NTNU-TDT4295/slamdunk/tools/simulator/assets/models/head.obj

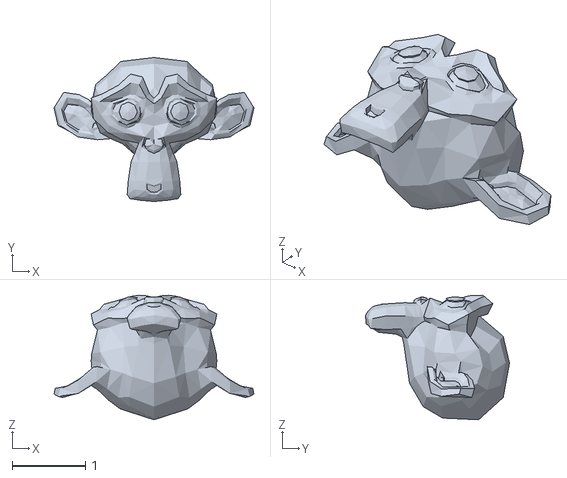
[picture p4: CAD file, 2018-09-21]
tools/simulator/assets/models/head.obj
2.73 x 1.97 x 1.70
