NTNU-TDT4295/slamdunk/tools/simulator/assets/models/sphere.obj

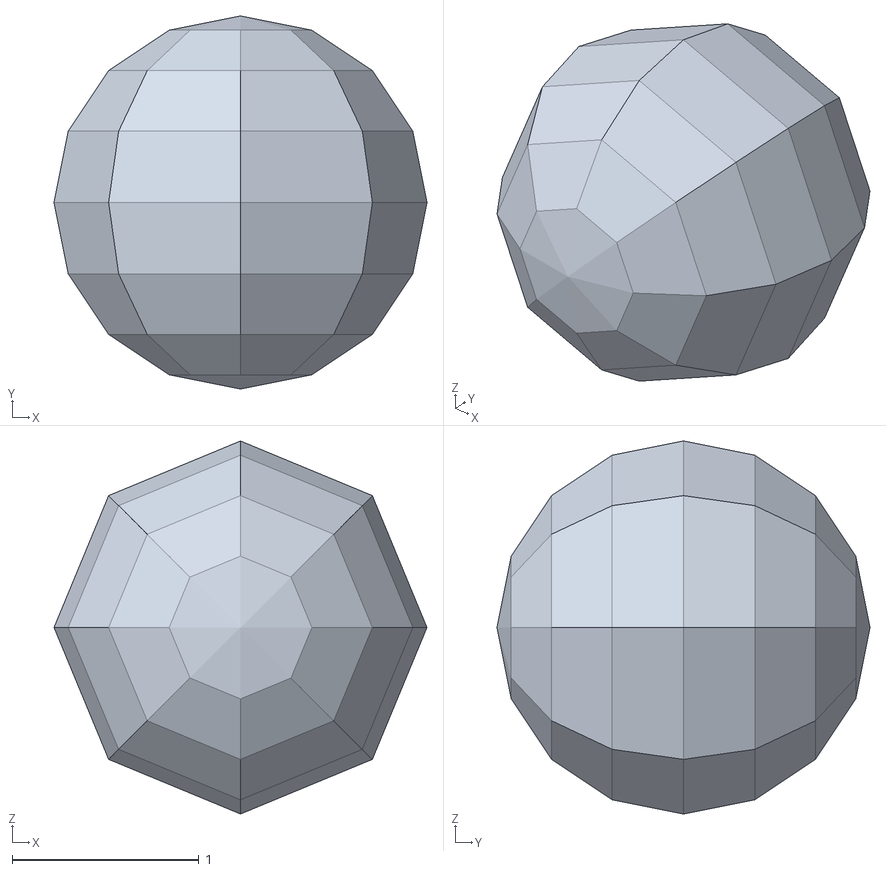
[picture p5: CAD file, 2018-09-20]
tools/simulator/assets/models/sphere.obj
2.00 x 2.00 x 2.00
