NTNU-TDT4295/slamdunk/tools/simulator/assets/models/room.obj

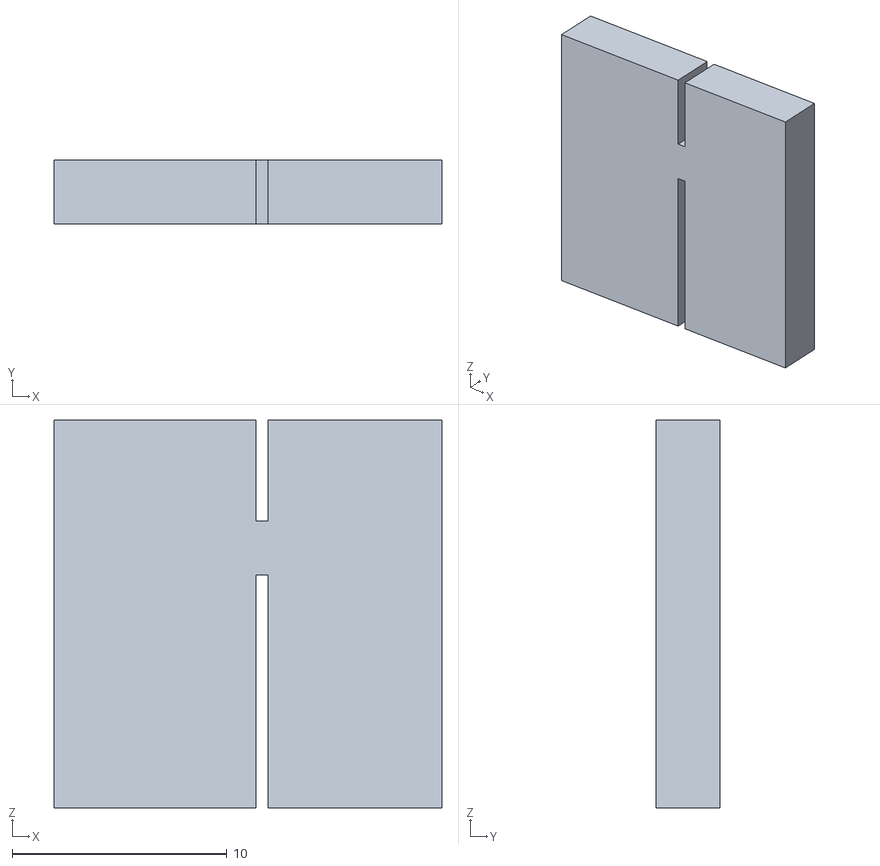
[picture p6: CAD file, 2018-09-18]
tools/simulator/assets/models/room.obj
18.1 x 3.00 x 18.0
