NTNU-TDT4295/slamdunk/tools/simulator/assets/models/cube.obj

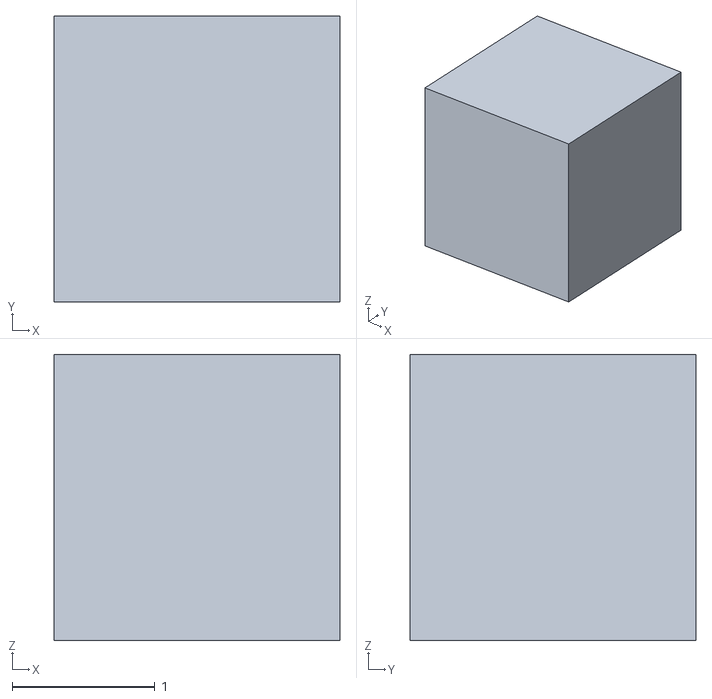
[picture p7: CAD file, 2018-09-18]
tools/simulator/assets/models/cube.obj
2.00 x 2.00 x 2.00
