NTNU-TDT4295/slamdunk/pcb/pcb.kicad_pcb

## KiCad design pcb/pcb.kicad_pcb (2018-10-03)

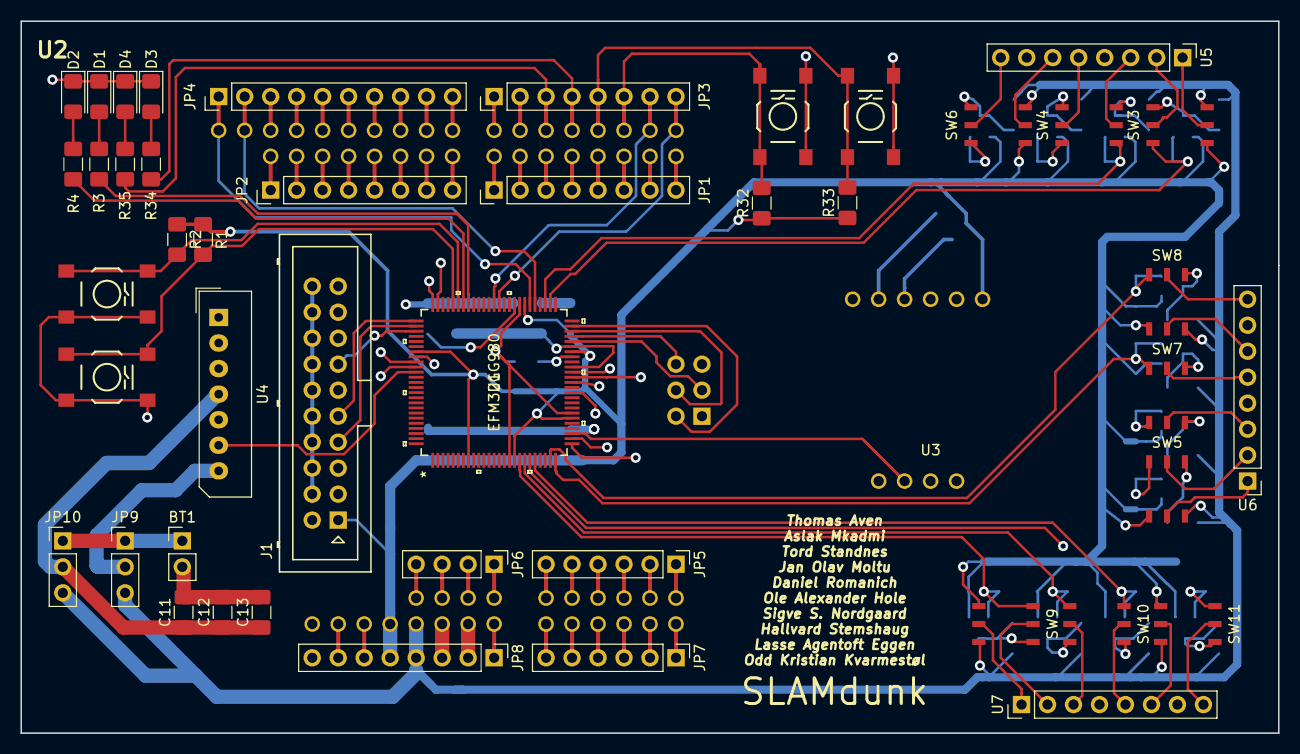
[picture p13: board pcb.kicad_pcb from above]

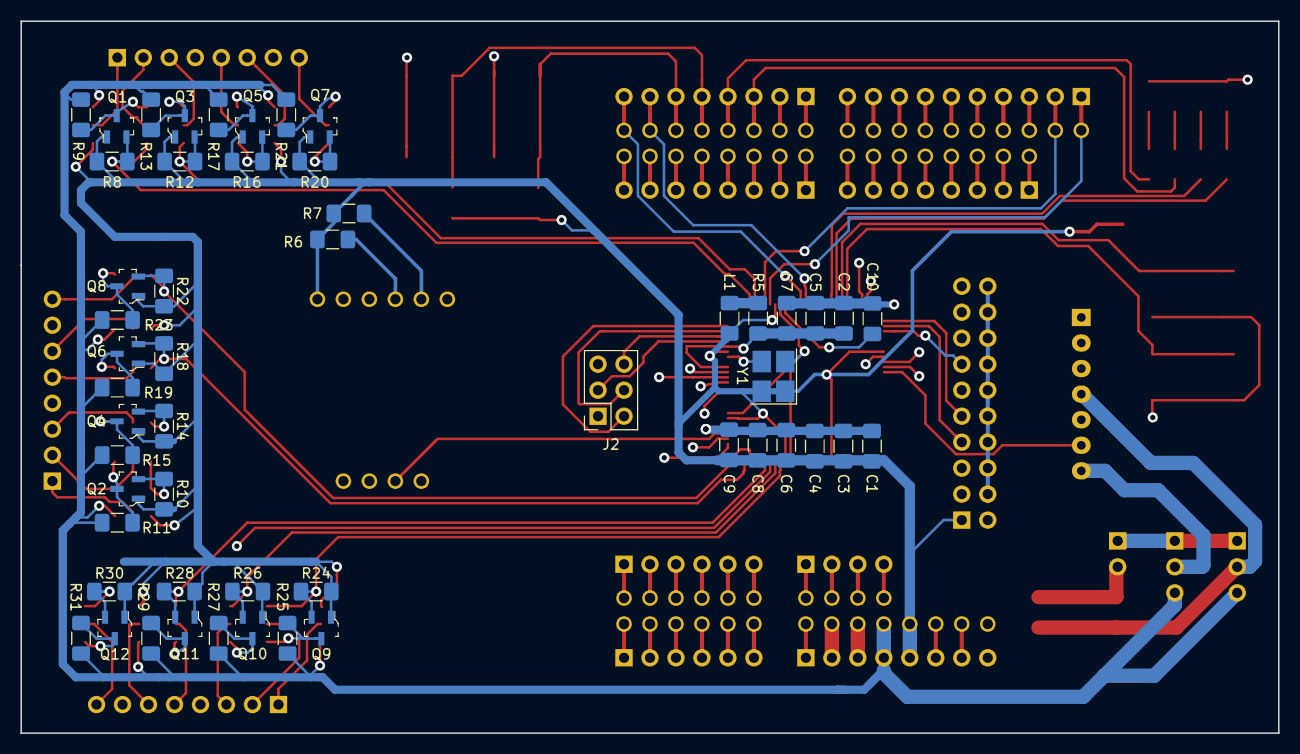
[picture p14: board pcb.kicad_pcb from below]

Board: 4 copper layers, 122.9 x 69.6 mm, 99 parts (52 on the bottom side), 128 nets.

Parts:
BT1: Battery; PinHeader_1x02_P2.54mm_Vertical
C1, C3, C4, C6, C8: 100n; C_1206_3216Metric_Pad1.42x1.75mm_HandSolder
C2, C5: 10nF; C_1206_3216Metric_Pad1.42x1.75mm_HandSolder
C7, C10: 1uF; C_1206_3216Metric_Pad1.42x1.75mm_HandSolder
C9: 10u; C_1206_3216Metric_Pad1.42x1.75mm_HandSolder
C11: 10μF; C_1206_3216Metric_Pad1.42x1.75mm_HandSolder
C12: 1μF; C_1206_3216Metric_Pad1.42x1.75mm_HandSolder
C13: 100nF; C_1206_3216Metric_Pad1.42x1.75mm_HandSolder
D1, D2, D3, D4: LED; LED_1206_3216Metric_Pad1.42x1.75mm_HandSolder
J1: Conn_02x10_Odd_Even; Multicomp_MC9A12-2034_2x10_P2.54mm_Vertical
J2: Conn_02x03_Counter_Clockwise; PinSocket_2x03_P2.54mm_Vertical
JP1, JP2, JP3, JP8: M08; PinHeader_1x08_P2.54mm_Vertical
JP4: M10; PinHeader_1x10_P2.54mm_Vertical
JP5, JP7: M06; PinHeader_1x06_P2.54mm_Vertical
JP6: M04; PinHeader_1x04_P2.54mm_Vertical
JP9, JP10: Jumper_NC_Dual; PinHeader_1x03_P2.54mm_Vertical
L1: 742792662; L_1206_3216Metric_Pad1.42x1.75mm_HandSolder
Q1, Q2, Q3, Q4, Q5, Q6, Q7, Q8, Q9, Q10, Q11, Q12: BSS138; SOT-23-3
R1, R2, R3, R4, R32, R33, R34, R35: R; R_1206_3216Metric_Pad1.42x1.75mm_HandSolder
R5: 1; R_1206_3216Metric_Pad1.42x1.75mm_HandSolder
R6: 2.2k; R_1206_3216Metric_Pad1.42x1.75mm_HandSolder
R7: 4.7k; R_1206_3216Metric_Pad1.42x1.75mm_HandSolder
R8, R9, R10, R11, R12, R13, R14, R15, R16, R17, R18, R19, R20, R21, R22, R23, R24, R25, R26, R27, R28, R29, R30, R31: 10k; R_1206_3216Metric_Pad1.42x1.75mm_HandSolder
SW1, SW2, SW12, SW13: SW_PUSHBUTTON; SW_PUSHBUTTON_SMD
SW3, SW4, SW5, SW6, SW7, SW8, SW9, SW10, SW11: SW_2xSPDT; CAS-D20TB
U1: EFM32GG980
U2: ARDUINO_PYNQ_SHIELD
U3: IMU; BNO055
U4: lidar; Molex_SPOX_5267-07A_1x07_P2.50mm_Vertical
U5, U6, U7: ULTRASONIC-GPIO; PinHeader_1x08_P2.54mm_Vertical
Y1: Crystal_GND23; Crystal_SMD_3225-4Pin_3.2x2.5mm_HandSoldering

Connections:
+3V3: C1.1, C3.1, C4.1, C6.1, C8.1, C9.1, J1.1, JP8.5, L1.1, Q1.1, Q2.1, Q3.1, Q4.1, Q5.1, Q6.1, Q7.1, Q8.1, Q9.1, Q10.1, Q11.1, Q12.1, R1.1, R2.1, R6.1, R7.1, R8.1, R10.1, R12.1, R14.1, R16.1, R18.1, R20.1, R22.1, R24.1, R26.1, R28.1, R30.1, R32.1, R33.1, SW3.3, SW5.3, SW6.3, SW8.3, SW9.3, SW11.3, U1.8, U1.17, U1.31, U1.44, U1.57, U1.82, U2.3V3, U3.6, Y1.1, Y1.4
/AVDD_DEC: C2.1, C5.1, C7.1, R5.2, U1.41, U1.45
/CLOCK/HFXTAL_N: U1.43, Y1.3
/DEC: C10.2, U1.59
/EFM_DEBUG/LED_1: R3.1, U1.68
/EFM_DEBUG/LED_2: R4.1, U1.69
/EFM_DEBUG/SW_1: R1.2, SW1.1, U1.71
/EFM_DEBUG/SW_2: R2.2, SW2.1, U1.70
/JTAG/SWCLK: J1.9, U1.76
/JTAG/SWDIO: J1.7, U1.77
/JTAG/SWO: J1.13, U1.78
/LIDAR/MOTO_CTRL: U1.86, U4.6
/LIDAR/RX: U1.85, U4.3
/LIDAR/TX: U1.84, U4.2
/MCU_RST: J1.15, U1.36
/PA7_C1: Q2.2, R10.2, SW5.6, U1.26
/PA8_C2: Q4.2, R14.2, SW7.3, U1.27
/PA9_IMU_INT: U1.28, U3.9
/PB7_CTX: Q8.2, R22.2, SW8.6, U1.24
/PB8_CRX: Q6.2, R18.2, SW7.6, U1.25
/PB10_IMU_RST: U1.38, U3.1
/PB11_IMU_SDA: R6.2, U1.39, U3.3
/PB12_IMU_SCL: R7.2, U1.40, U3.2
/PC0_B1: Q9.2, R24.2, SW9.6, U1.18
/PC1_B2: Q10.2, R26.2, SW10.3, U1.19
/PC2_BTX: Q12.2, R30.2, SW11.6, U1.20
/PC3_BRX: Q11.2, R28.2, SW10.6, U1.21
/PD6_A1: Q1.2, R8.2, SW3.6, U1.52
/PD7_A2: Q3.2, R12.2, SW4.3, U1.53
/PF10_ATX: Q7.2, R20.2, SW6.6, U1.74
/PF11_ARX: Q5.2, R16.2, SW4.6, U1.75
/PYNQ-DEBUG/LED_1: JP3.4, R34.1, U2.4
/PYNQ-DEBUG/LED_2: JP3.3, R35.1, U2.5
/PYNQ-DEBUG/SW_1: JP3.6, R32.2, SW12.1, U2.2
/PYNQ-DEBUG/SW_2: JP3.5, R33.2, SW13.1, U2.3
/PYNQ_RX: JP3.8, U1.62, U2.0
/PYNQ_SCL: JP4.1, U1.56, U2.SCL
/PYNQ_SDA: JP4.2, U1.55, U2.SDA
/PYNQ_TX: JP3.7, U1.63, U2.1
/SPI/MISO: J2.6, U1.47
/SPI/MOSI: J2.3, U1.46
/SPI/SCLK: J2.4, U1.48
/SPI/SS: J2.2, U1.49
GND: BT1.2, C1.2, C2.2, C3.2, C4.2, C5.2, C6.2, C7.2, C8.2, C9.2, C10.1, C11.2, C12.2, C13.2, D1.1, D2.1, D3.1, D4.1, J1.4, J1.6, J1.8, J1.10, J1.12, J1.14, J1.16, J1.18, J1.20, JP8.2, JP8.3, SW1.2, SW2.2, SW12.2, SW13.2, U1.16, U1.32, U1.58, U1.83, U2.GND1, U2.GND2, U3.4, U4.1, U4.5, U5.4, U5.7, U6.4, U6.7, U7.4, U7.7, Y1.2
unnamed: BT1.1, JP9.1, JP10.1
unnamed: C11.1, C12.1, C13.1, JP10.2, U4.4
unnamed: D1.2, R3.2
unnamed: D2.2, R4.2
unnamed: D3.2, R34.2
unnamed: D4.2, R35.2
unnamed: JP1.1, U2.33
unnamed: JP1.2, U2.32
unnamed: JP1.3, U2.31
unnamed: JP1.4, U2.30
unnamed: JP1.5, U2.29
unnamed: JP1.6, U2.28
unnamed: JP1.7, U2.27
unnamed: JP1.8, U2.26
unnamed: JP2.1, U2.41
unnamed: JP2.2, U2.40
unnamed: JP2.3, U2.39
unnamed: JP2.4, U2.38
unnamed: JP2.5, U2.37
unnamed: JP2.6, U2.36
unnamed: JP2.7, U2.35
unnamed: JP2.8, U2.34
unnamed: JP3.1, U2.7
unnamed: JP3.2, U2.6
unnamed: JP4.3, U2.A_R
unnamed: JP4.4, U2.G
unnamed: JP4.5, U2.13
unnamed: JP4.6, U2.12
unnamed: JP4.7, U2.11
unnamed: JP4.8, U2.10
unnamed: JP4.9, U2.9
unnamed: JP4.10, U2.8
unnamed: JP5.1, U2.A11
unnamed: JP5.2, U2.A10
unnamed: JP5.3, U2.A9
unnamed: JP5.4, U2.A8
unnamed: JP5.5, U2.A7
unnamed: JP5.6, U2.A6
unnamed: JP6.1, U2.XV_R
unnamed: JP6.2, U2.XGND
unnamed: JP6.3, U2.V_N
unnamed: JP6.4, U2.V_P
unnamed: JP7.1, U2.A5
unnamed: JP7.2, U2.A4
unnamed: JP7.3, U2.A3
unnamed: JP7.4, U2.A2
unnamed: JP7.5, U2.A1
unnamed: JP7.6, U2.A0
unnamed: JP8.1, U2.VIN
unnamed: JP8.6, U2.RST
unnamed: JP8.7, U2.IO_R
unnamed: JP9.2, U4.7
unnamed: L1.2, R5.1
unnamed: Q1.3, R9.2, SW3.4
unnamed: Q2.3, R11.2, SW5.4
unnamed: Q3.3, R13.2, SW4.1
unnamed: Q4.3, R15.2, SW7.1
unnamed: Q5.3, R17.2, SW4.4
unnamed: Q6.3, R19.2, SW7.4
unnamed: Q7.3, R21.2, SW6.4
unnamed: Q8.3, R23.2, SW8.4
unnamed: Q9.3, R25.2, SW9.4
unnamed: Q10.3, R27.2, SW10.1
unnamed: Q11.3, R29.2, SW10.4
unnamed: Q12.3, R31.2, SW11.4
unnamed: SW3.2, U5.1
unnamed: SW3.5, U5.2
unnamed: SW4.2, U5.3
unnamed: SW4.5, U5.5
unnamed: SW5.2, U6.1
unnamed: SW5.5, U6.2
unnamed: SW6.2, U5.6
unnamed: SW6.5, U5.8
unnamed: SW7.2, U6.3
unnamed: SW7.5, U6.5
unnamed: SW8.2, U6.6
unnamed: SW8.5, U6.8
unnamed: SW9.2, U7.1
unnamed: SW9.5, U7.2
unnamed: SW10.2, U7.3
unnamed: SW10.5, U7.5
unnamed: SW11.2, U7.6
unnamed: SW11.5, U7.8
VCC: JP8.4, JP9.3, JP10.3, R9.1, R11.1, R13.1, R15.1, R17.1, R19.1, R21.1, R23.1, R25.1, R27.1, R29.1, R31.1, SW3.1, SW5.1, SW6.1, SW8.1, SW9.1, SW11.1, U2.5V
