NTNU-TDT4295/slamdunk/efm32/source/sonar.c

#include "sonar.h"
#include "setup.h"
#include <stdio.h>

void sonar_callback(uint8_t pin)
{
	/* // Time the amount of microseconds the pin is high */
	/* uint32_t microsecond = TIMER_FREQ / 1000000; */
	/* uint32_t elapsed = 0; */

	/* TIMER0->CNT = 0; */
	/* TIMER0->CMD = TIMER_CMD_START; */

	/* while (GPIO_PinInGet(gpioPortD, 2)) { */
	/* 	// Gernal purpose timers are 16-bit, we need to extend */
	/* 	// this to account for overflow later (TODO) */
	/* 	if (TIMER0->CNT > 65000) { */
	/* 		elapsed = 0; */
	/* 		break; */
	/* 	} else { */
	/* 		elapsed = TIMER0->CNT; */
	/* 	} */
	/* } */

	/* TIMER0->CMD = TIMER_CMD_STOP; */
}

void init_sonar()
{
	// Interrupt dispatcher
	GPIOINT_Init();

	// PD2 - echo, PD3 - trig
	GPIO_PinModeSet(gpioPortD, 2, gpioModeInput, 0);
	GPIO_PinModeSet(gpioPortD, 3, gpioModePushPull, 0);

	// Port, pin, rising edge, falling edge, enable
	GPIO_IntConfig(gpioPortD, 2, true, false, true);

	// IRQ handlers are defined in gpiointerrupt.c to dispatch
	// callbacks so that we don't scatter definitions
	GPIOINT_CallbackRegister(2, sonar_callback);
}

void trigger_sonar()
{
	GPIO_PinOutClear(gpioPortD, 3);
	DelayUs(2);
	GPIO_PinOutSet(gpioPortD, 3);
	DelayUs(10);
	GPIO_PinOutClear(gpioPortD, 3);

	// Check echo -- this is interrupt driven for now (TODO)
}
