NTNU-TDT4295/slamdunk/efm32/include/setup.h

#ifndef SETUP_H
#define SETUP_H

#include <stdint.h>
#include <stdbool.h>
#include "em_chip.h"
#include "em_cmu.h"

#define RTC_FREQ 32768
#define TIMER_FREQ 48000000

// counter for Delay ticks to sleep
volatile uint32_t msTicks;
void Delay(uint32_t dlyTicks);
void DelayMs(int ms);
void DelayUs(int us);
void SysTick_Handler(void);

void init(void);

#endif
