NTNU-TDT4295/slamdunk/(commit log)

2018-09-06 Use an accelerator to move memory in DRAM with DMA (streams).
2018-09-06 Remove previous testing that is no longer needed.
    [run.cpp]
2018-09-08 Add some UART modules, including a few things QBART used last year.
2018-09-12 Add GPIO interrupts
2018-09-12 Successfully send some data over UART (i.e. uncomment IRQ-handler..).
2018-09-13 Add missing stdio header, and update serial.h correctly.
    [serial.h]
2018-09-13 Change baud rate to 115200, and location to PB{9,10} for UART.
2018-09-13 Write UART input to LCD screen.
2018-09-13 Enable UART0 so it works to speak to the chip on two channels.
2018-09-14 add i2c driver
2018-09-14 I2C, scaffold and initial test.
2018-09-15 Successfully check the system status of the BNO055 and start set IMU mode.
2018-09-15 Fetch some euler angles, only works for a little bit before crashing the EFM32.
    [main.c, serial.h]
2018-09-15 Only fetch the x-dir euler angle, as this doesnt seem to crash the EFM32.
    [main.c, serial.c]
2018-09-16 Move up and down with camera pitch
2018-09-16 Fix keyboard keys getting stuck on key repeat
    [main.cpp]
2018-09-18 Split out camera code
2018-09-18 Add PCB project
    [pcb.kicad_pcb, pcb.sch]
2018-09-18 Add symbols for EFM32, IMU and sonars
    [pcb.sch]
2018-09-18 Make I2C independent from own BNO055 module.
2018-09-18 Refactor fetching euler samples, and use a simple example to display pitch.
2018-09-19 Create fairly simple driver for HC-SR04.
2018-09-20 Add first draft of pcb
    [DEBUG.sch, _saved_EFM32.sch, _saved_pcb.sch]
2018-09-20 Change clock pin
    [DEBUG.sch, _saved_pcb.sch, pcb.sch]
2018-09-20 Add pcb decoupling
    [DEBUG.sch, decoupling.sch, pcb.sch]
2018-09-20 Add 'sensor ball' to simulator
    [sphere.obj]
2018-09-20 Implement drawing rays from the sensor
2018-09-21 Make overflow of TIMER0 the time out of HC-SR04.
2018-09-21 Make uartPutChar take an UART channel as input.
2018-09-21 Also transfer IMU status on UART channel 1 (to PYNQ).
2018-09-21 Fix mouse grab on window focus loss
    [main.cpp, octree.cpp, simulator.cpp]
2018-09-21 Implement rotation of sensor
2018-09-21 Fetch quaternion data and send it to PYNQ over UART.
2018-09-21 Fixed rotation input into simulator
    [head.obj]
2018-09-21 Add test reflector of IMU data from PYNQ.
2018-09-23 Attempt initializing interrupts from IMU movement (doesn't work yet).
    [bno055.c, bno055.h]
2018-09-23 Invert quaternion values to seemingly fit the expected rotations (hack, wat)
    [simulator.cpp]
2018-09-23 Use int16_t for IMU values and send them without delay.
2018-09-23 Add script for plotting accelerometer data from the pynq
2018-09-25 lagt til SPI
    [DEBUG.sch, decoupling.sch, pcb.sch]
2018-09-25 Added levelswitch
    [DEBUG.sch, decoupling.sch, file5BAA6CA8.sch, levelswitch.sch, pcb.sch]
2018-09-26 Prettyfy Schematic
    [CLOCK.sch, DEBUG.sch, EFM_DEBUG.sch, IMU.sch, JTAG.sch, LEVELSHIFT.sch, LIDAR.sch, SPI.sch]
2018-09-26 Add PYNQ debug pins
    [CLOCK.sch, DECOUPLING.sch, EFM_DEBUG.sch, IMU.sch, JTAG.sch, LIDAR.sch, OLD-SONAR.sch, PYNQ-DEBUG.sch]
2018-09-26 Finishe schematic, add netlist and start editing pcb design
    [CLOCK.sch, DECOUPLING.sch, EFM_DEBUG.sch, IMU.sch, JTAG.sch, LIDAR.sch, OLD-SONAR.sch, PYNQ-DEBUG.sch]
2018-09-26 start on pcb layout
    [pcb.kicad_pcb]
2018-09-27 Add IMU footprint
    [IMU.sch, JTAG.sch, pcb.kicad_pcb]
2018-09-27 continue on pcb
    [DECOUPLING.sch, EFM_DEBUG.sch, LIDAR.sch, OLD-SONAR.sch, PYNQ-DEBUG.sch, SPI.sch, pcb.kicad_pcb, pcb.sch]
2018-09-28 Add level shifters and jumpers and new gpio
    [CLOCK.sch, IMU.sch, JTAG.sch, LIDAR.sch, SONAR-GPIO.sch, _saved_OLD-SONAR.sch, _saved_pcb.sch, pcb.kicad_pcb]
2018-09-28 Connect some more wires
    [SONAR-GPIO.sch, _saved_pcb.sch, pcb.kicad_pcb, pcb.sch]
2018-10-01 Think it is somewhat finished
    [CLOCK.sch, DECOUPLING.sch, EFM_DEBUG.sch, IMU.sch, JTAG.sch, LIDAR.sch, PYNQ-DEBUG.sch, SONAR-GPIO.sch]
2018-10-02 Add BNO055 footprint
2018-10-02 remove extra footprint
2018-10-02 Some small fixes and gerber files
    [pcb-B.Cu.gbr, pcb-B.Mask.gbr, pcb-B.Paste.gbr, pcb-B.SilkS.gbr, pcb-Edge.Cuts.gbr, pcb-F.Cu.gbr, pcb-F.Mask.gbr, pcb-F.Paste.gbr]
2018-10-03 Fix pin silk and size of IMU
    [IMU.sch, LIDAR.sch, pcb.kicad_pcb]
2018-10-03 Fix design rules
    [pcb-B.Cu.gbr, pcb-B.Mask.gbr, pcb-B.Paste.gbr, pcb-B.SilkS.gbr, pcb-Edge.Cuts.gbr, pcb-F.Cu.gbr, pcb-F.Mask.gbr, pcb-F.Paste.gbr]
2018-10-03 Implement lidar output visualizer
2018-10-07 SPI master->slave: efm32gg->PYNQ.
2018-10-07 Lidar initialization
2018-10-07 More lidar headers
2018-10-07 Fetch and forward rotation data from Lidar over UART.
2018-10-07 Send a start byte and theta + distance from LIDAR to UART output.
2018-10-07 Reset LIDAR properly on reset, and clear incoming RX.
    [main.c]
2018-10-07 Don't continuously send LIDAR data.
2018-10-07 Make LIDAR code a bit more self contained.
2018-10-07 Make it simpler to output LIDAR samples.
2018-10-07 Each LIDAR sample is 5 bytes.
2018-10-07 Implement sending data readings to the lidar visualizer from the simulator
2018-10-08 Clean up slightly, add interleaving of IMU-data.
2018-10-08 Actually pass IMU data along with LIDAR data.
    For later: the breadboard seems to not work as expected when you wish
    to move the LIDAR. This may result in very painful debugging sessions.
    [main.c, test_serial.py]
2018-10-08 Print values reflected by test_serial to pointcloud.
2018-10-17 Factor out lidar input
2018-10-19 Add wireless kernel module for USB dongle.
2018-10-19 add kernel module for wifi driver
2018-10-20 Fix some more issues with hector slam
    [lidar_socket.h]
2018-10-22 Invariant SPI config.
2018-10-22 SPI for PYNQ. SPI header pins.
2018-10-22 Add test lidar reading application
2018-10-22 SPI basic chisel peek/poke test.
2018-10-22 Efm and pynq SPI conformance. Testable setup.
2018-10-23 SPI -> 32 bit 2048 addr bram buffer.
2018-10-23 EFM SPI test setup. Alphabet 500 kHz.
2018-10-24 PoC Lidar data on SPI BRAM
2018-10-24 Checkpoint SPI (Charlie).
2018-10-24 Checkpoint for PoC LIDAR -> SPI.
2018-10-24 Itty bitty change for PoC to properly read all LIDAR data.
2018-10-25 Continuously send LIDAR data from EFM.
2018-10-25 Lidar angle distance from BRAM.
2018-10-25 also setup wifi driver
2018-10-25 Integrating projects. FPGA driver base.
2018-10-26 Enable lidar motor GPIO pin
2018-10-26 remove hardcoding of uart channels in lidar.
2018-10-26 Reflect SPI header moved to sd pins.
2018-10-27 UART device and location EFM@pcb pinout
2018-10-27 SPI @pcb modded pins.
2018-10-28 Fix issues related to tile transfer.
    Implicit types in C/C++ can be a pain... (1 << 64) returns a 32-bit number.
    [slam_vis_net.h]
2018-10-28 Implement visualizing the current position of the lidar
2018-10-28 Implement visualizing the path traveled by the lidar
2018-10-29 Remapping botched pcb pins.
2018-10-30 Toggle lidar button efm32gg.
2018-10-30 Reset button for FPGA SPI buffers. For lidar sync.
2018-10-30 Send data over SPI, no UART debug.
2018-10-30 IMU I2C setup for PCB layout.
2018-11-02 Cleanup SPI chisel.
2018-11-03 Update EFM32 main.c with current stable behaviour.
2018-11-03 Remove unused leds.{c,h}.
2018-11-03 Move interrupt.{c,h} to just gpio.{c,h}.
2018-11-03 BNO055 -> IMU, and remove some unused stuff.
2018-11-03 Remove some unused stuff from LIDAR interfacing.
2018-11-03 Remove unused I2C code.
2018-11-03 Comment out sonar callback (false unused positives).
2018-11-03 Implement a new project structure
    [cube.obj, head.obj, mountain.obj, room.obj, sphere.obj]
2018-11-06 Fix disconnection bug and lower update cutoff.
    [run.cpp]
2018-11-16 Fix aspect ratio of slamvis
    [slamvis.cpp]
2018-11-16 Fix the red indicator not being scaled properly
    [slamvis.cpp]
2018-11-16 Implement visualising real-time lidar data
